SouthEastFPV/Typhon/README.md

# Typhon
Open Source FPV 5" & 6" Drone Racing Frame project initiated by SouthEastFPV - Rick Caudle AKA - SSBelmont
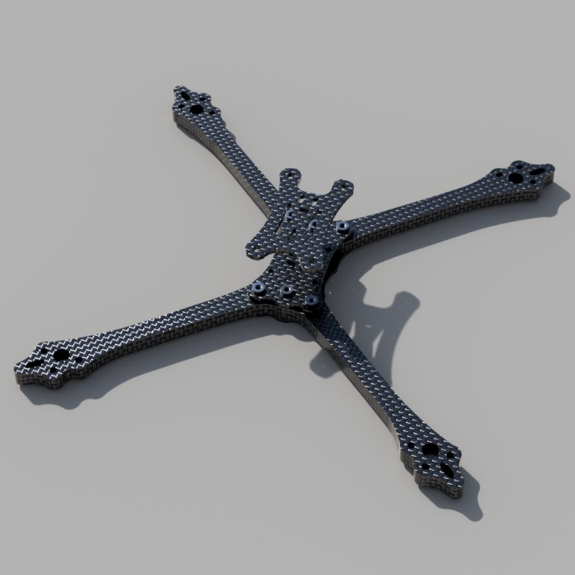
[picture p1: Images/T_v7_Assembly.jpg]


# About Typhon
## The idea
The Typhon was born out of the need for a 6" lite weight race frame that is durable and can compete with the fastest pilots in the world.  This is a design concept I came up and iterated on with Mason "Hyper" Lively as well as Randy "Gator" Jeppesen over the course of the 2021 season and this is the 7th version and it has turned out perfect. This frame allowed Mason to capture the Top Qualifying Time at the 2021 MultiGP Champs with Mason finishing in 5th (two mid-airs). Sp3cimen finished 3rd on this frame in the Sportsman Class and several others making it the top 40 and next 40.  The frame is 25-30g lighter than other 6" race frames and if I released 5" arms it would be lighter than that bestselling 5" race frames on the market and surely more durable.  This current designed if using T700 for the arms is in fact more durable than the top selling race from on the market as of 2021.

Top MultiGP Pilots currently flying this frame are Mason "Hyper" Lively, Tristan "TDog_FPV" Tefft, Rick "SSBelmont" Caudle, Randy "Gator" Jeppesen, Ryan "MegaHurts" Davis, ProDangles, SolidFPV, CoryRC, Sp3cimen and several other pilots.

Typhon
Typhon (/ˈtaɪfɒn, -fən/; Greek: Τυφῶν, [typʰɔ̂ːn]), also Typhoeus (/taɪˈfiːəs/; Τυφωεύς), Typhaon (Τυφάων) or Typhos (Τυφώς), was a monstrous serpentine giant and one of the deadliest creatures in Greek mythology. According to Hesiod, Typhon was the son of Gaia and Tartarus. However, one source has Typhon as the son of Hera alone, while another makes Typhon the offspring of Cronus. Typhon and his mate Echidna were the progenitors of many famous monsters.

# Changelog
## 4/16/2013
- Refactored the repo added various folders making it easier to navigate and understand what is what
- Created/Added **Long and Extra Long Bodies** to accomidate the new ESCs [click here](/Long%20Bodies/Readme.md) to navigate to the Long Bodies.
- Created/Added **Shorty Arms** (5" Short Arms) section [click here](/Shorty%20Arms/Readme.md) to navigate to the Shorty Arms.
- Created/Added **Arm Locks** section [click here](/Arm%20Locks/Readme.md)to navigate to the Arm Locks.
- Created folder for long arms (6" Arms) [click here](/Long%20Arms) to navigate to the Long Arms folder.

## Frame specifications
* Wheelbase 5" or 6": 226mm (when using the 6" arms)
* Top plate: 2mm
* Mid plate: 2mm
* Bottom plate 2mm
* Arm: 6mm or 5mm
* Brace: 4mm (braces are optional, I personally don't use them)
* Lipo Pad: 2mm (will release files soon)
* Stack mounting:  20 x 20
* Weight 6": 54g (lighter if using 5" shorty arms)

## Hardware
* 4x M3x20 or M3x25 Knurled Standoffs  (personal preference)
* 2x M3x10 Flat Head Socket Bolts 12.9 Black Steel
* 4x M3x18 Flat Head Socket Bolts 12.9 Black Steel
* 4x M3x8 Button Head Bolts
* 12x M3x8mm Socket Head Bolts (motor mounting)
* 6x M3 Press Nuts
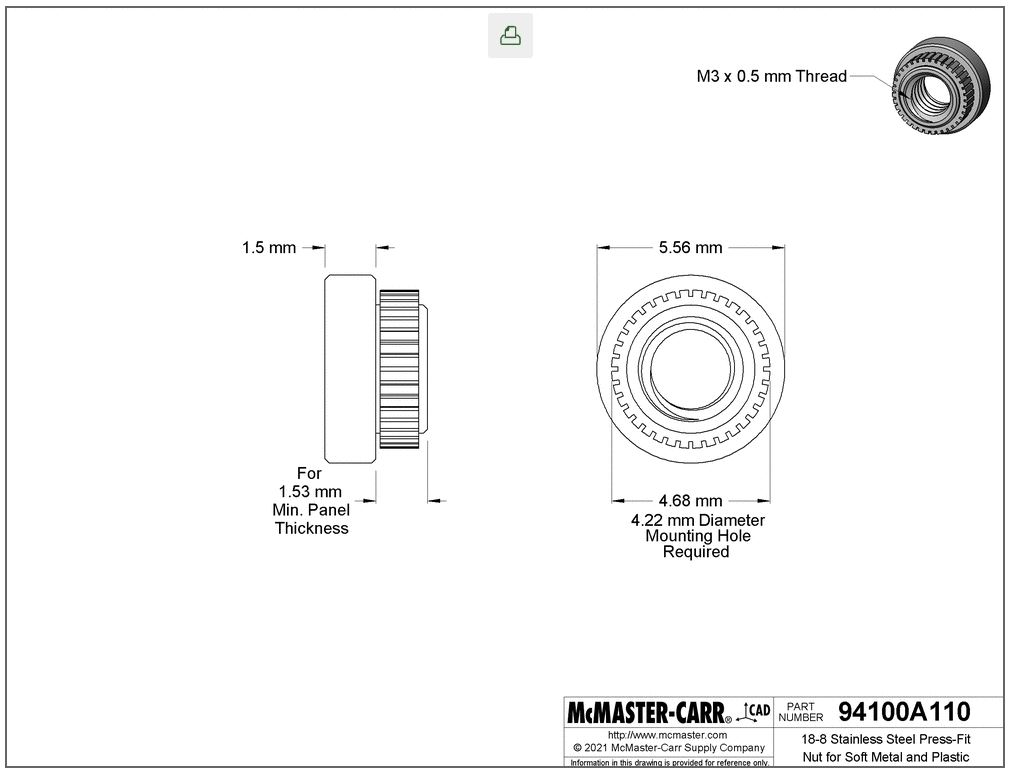
[picture p2: Images/PressNut.JPG]


## Additional Arms
I have designed a short skinny 5" arm in both 5mm and 6mm thickness.  I have also designed a 5.5" skinny arm that is based on the short skinny arm in both 5mm and 6mm thickness.  Again, it's important to use T700 CF and often times China will sell you T300 and tell you it's T700.  One way to tell is it's T300 is to break a known T300 arm and break T700 arm, the CF thread count is higher for the T700.  It's not perfect but if the 6mm arms are breaking and getting twisty after 10-20 packs it's likely not T700.  I have had 6mm T700 arms last me the whole season in 2021 all the way up to IO.

I have included .STEP, .F3D and .IGES files.  In some cases I provide .DXF but the .STEP, F3D and .IGES files are 3D drawings, so if you need a 2D file you can export form these.  All these files can be find in the folder.

## Shorty 5" Arms
[Click here](/Shorty%20Arms/Readme.md) to navigate to the Shorty Arm section.<br>
[5" 5mm Shorty Arms](/Shorty%20Arms/5mm)<br>
[5" 6mm Shorty Arm](/Shorty%20Arms/6mm)<br>
[5" Shorty Arm Braces](/Shorty/Arm%20Brace/)

Don't forget to have some arm locks cut!

## Arm Locks
You will need quanity 2 of these for each build.
[Click here](/Arm%20Locks/Readme.md) to navigate to the Arm Locks section

## Original Body
The frame was originally designed with these files being used for the mid-body section.<br>
[Click here](/Regular%20Body) to navigate to the Original Body section/files.

## Long & Extra Long Bodies
These mid-bodies are perfect for the longer 20x20 ESCs.<br>
[Click here](/Long%20Bodies) to navigate to the Original Body section/files.

## Original Arms
This frame was originally designed with a longer arm (6") as Hyper liked the longer arms with a 5.1" prop. <br>
[Click here](/Long%20Arms) to navigate to the Original Arms section/files.

## Conclusion
My general conclusion is our motors have so much torque today, you need a wider 5mm Arm or a thicker skinny arm and it needs to be cut from T700 CF.  So the 5" 5mm skinny arms I am not a huge fan of (I recommend an arm brace when using 5mm skinny arms).  You will get much better performance from a 6mm skinny arm with very little additional weight.  It's possible to cut these out of 5.5mm thickness but I think it's a waste of time, just use 6mm, the weight savings isn't worth it. 

## Project links
* Project discussion: https://discord.gg/AsXFzmGM
* Project files: https://github.com/SouthEastFPV/Typhon
* 3D-printed accessories: https://www.thingiverse.com/tag:typhon

Please use the tag "typhon" when uploading files to thingiverse.com

## Where to buy
* You can purchase a Typhon from https://dindrones.com/. Din is a trusted business owner and avid MultiGP Pro Pilot and is well known.

## Carbon Fiber sources and CNC Services
More Information on CNC/Carbon Fiber cutting services 
[click here](/CNC/CF_CNCServices.md)

### Typhoon v7
* v7 Design complete/tested/vetted during many MultiGP Events and flown by many of the Top MultiGP Pilots i.e. Mason "Hyper" Lively, Tristan "TDog_FPV" Tefft, Rick "SSBelmont" Caudle, Randy "Gator" Jeppesen, Ryan "MegaHurts" Davis, ProDangles, SolidFPV, CoryRC, Sp3cimen

* initial release from SouthEast FPV

## Project license
The frame files are released under GNU Public License (GPL) V3. More information here: https://www.gnu.org/licenses/gpl-3.0.en.html.  If you design any new parts for this frame, per the license you need to make those files availabe to the public.  

## Project naming requirements
Typhon is the name of the frame.  If you are thinking about manufacturing it, you are expected to prefix the name with a brand name in order to allow customers to distinguish the different manufacturers, e.g. “SOUTHEAST TYPHON”. As a manufacturer you are also expected to denote the version number of the frame files that you have used as basis of the project, e.g. “SOUTHEAST TYPHON V7”.

If you have forked the project, you need to give it another name in order to avoid confusion between TYPHON and your project.
Accessories from the TYPHON project also needs to be named with the entire prefix, e.g. “SOUTHEAST TYPHON FPV Camera Mount”. Unless the file is not compatible with certain versions of the frame, the compatible version number or version range also needs to be included in the name, e.g. “SOUTHEAST TYPHON FPV Camera Mount V1 - V2”.
