SouthEastFPV/Typhon/Shorty Arms/Readme.md

# Typhon Shorty Arms 
**Update: 4/16/2023** <br>
**Adds Made By: Rick (SSBelmont)**

These arms are as short as possible but will still allow for a 5.1" props.  The goal is to have a very light arm but yet still durable.  I run both the Shorty 5mm Arms and 6mm Arms (I lean toward the 6mm arms).

Take a look at the images below to get an idea of the difference in sizes.

## Shorty Arm
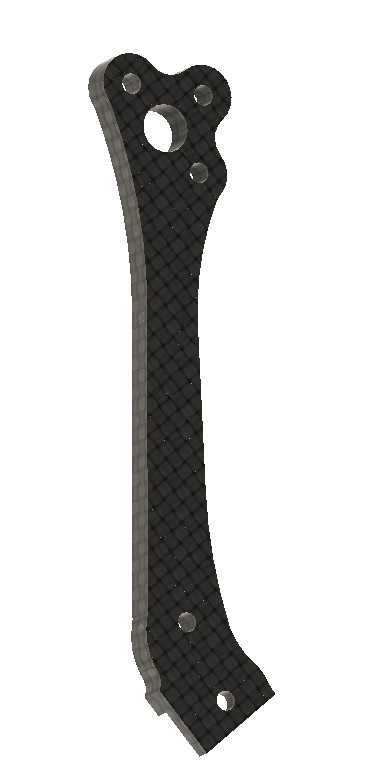
[picture p3: Images/Shorty_Arms/Shorty_Arm.jpg]


## Shorty Arm Brace
I don't run the brace with my 6mm Arms but I do run it on my Shorty 5mm Arm builds.  You don't have to use the brace with the 5mm arms, but you will find it allows the arms to last much longer.  As with any skinny 5mm Arm, they will delaminate over time and will get twisty resulting in the quad not flying as well (will cause hot motors as well).
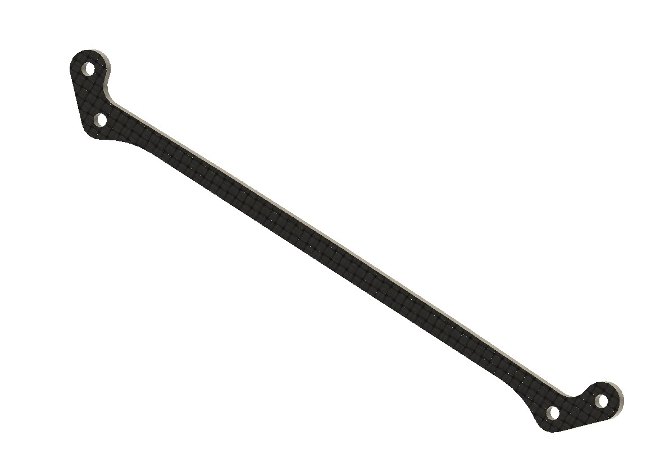
[picture p4: Images/Shorty_Arms/Shorty_Arm_Brace_3mm.jpg]


Shorty Arm File(s):
| Description | File(s) |
| ---- | ---- |
| 5mm Shorty Arm | T_v8_Bottom_Plate_L.dxf or T_v8_Bottom_Plate_L.step |
| 6mm Shorty Arm | T_v7_Shorty_Arm_5_Inch_6mm.dxf, T_v7_Shorty_Arm_5_Inch_6mm.step |

[Click here](/Shorty%20Arms/5mm) to navigate to the 5mm Shorty Arms folder to download files.<br>
[Click here](/Shorty%20Arms/6mm) to navigate to the 6mm Shorty Arms folder to download files.

## Don't forget your Arm Locks!
[Click here](/Arm%20Locks/Readme.md) to navigate to the Arm Locks Section.

## Files are located in their respective folders
Navigate to the folder and download the files you need, or learn how to use GitHub and clone the repo locally to get all the files, or download the repo as a zip file.
