SouthEastFPV/Typhon/Long Bodies/Readme.md

# Typhon Long Bodies
**Update: 4/16/2023** <br>
**Adds Made By: Rick (SSBelmont)**

Many people have asked me to design a long body in order to allow for the longer ESCs that are being sold today.  As result I have created two long bodies, a Long and an Extra Long version.  The Long version will work fine with with the TMotor 60a, Foxeer Reaper Slim, Rush, Redux 60a, Redux 70a.  The XL will work with any of the 20x20 ESCs on the market and gives more clearance near the center pressnut in the mid-plate.

Take a look at the images below to get an idea of the difference in sizes.

## Long & Extra Long Bodies
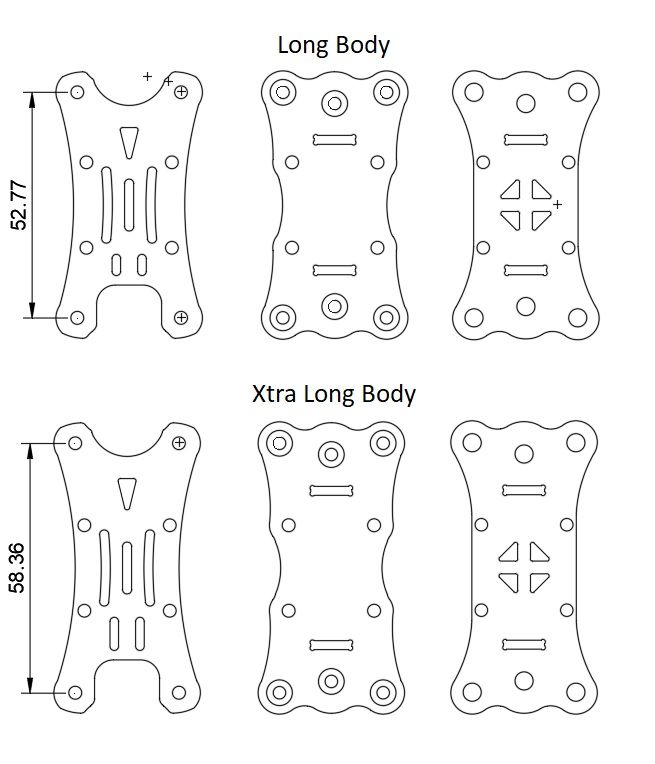
[picture p5: Images/Long_Body/Long Bodies.jpg]

Long Body File(s):
| Description | File(s) |
| ---- | ---- |
| Long Bottom Plate | T_v8_Bottom_Plate_L.dxf or T_v8_Bottom_Plate_L.step |
| Long Mid Plate | T_v8_Mid_Plate_L.dxf or T_v8_Mid_Plate_L.step |
| Long Top Plate |  T_v8_Top_Plate_L.dxf or T_v8_Top_Plate_L.step |

Extra Long Body File(s):
| Description | File(s) |
| ---- | ---- |
| XL Bottom Plate | T_v9_Bottom_Plate_XL_2mm.dxf or T_v9_Mid_Plate_XL_2mm.step|
| XL Mid Plate | T_v9_Mid_Plate_XL_2mm.dxf or T_v9_Mid_Plate_XL_2mm.step |
| XL Top Plate | T_v9_Top_Plate_XL.dxf or T_v9_Top_Plate_XL.step |

Now, compare the long bodies to the regular body to get a better understanding of the differences

## Regular Body
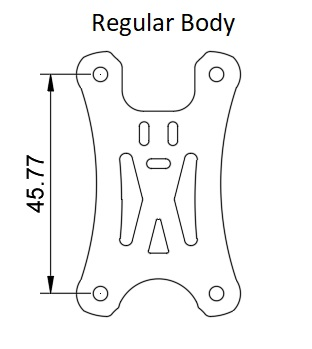
[picture p6: Images/Long_Body/Regular Body.jpg]


## Files are located in their respective folders
Navigate to the folder and download the files you need, or learn how to use GitHub and clone the repo locally to get all the files, or download the repo as a zip file.

## Don't forget your Arm Locks!
[Click here](/Long%20Bodies/Long) to navigate to the Long Body Folder to download files.
