SouthEastFPV/Typhon/Regular Body/Readme.md

# Regular Body
This section contains all the mid-body parts for the original design.
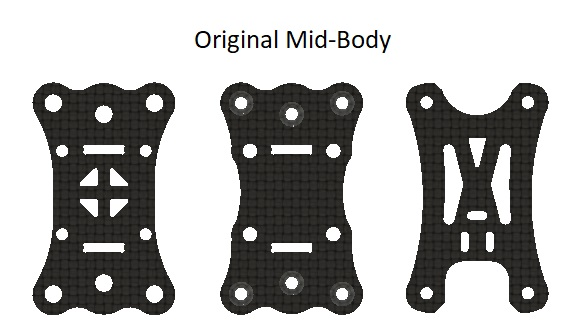
[picture p9: Images/Regular_Body/Regular Body.jpg]


This mid-body will be challenging to use with the longer style ESCs, you may want to checkout the Long Bodies if you plan to run longer 20x20 ESCs.<br>  
[Click here](/Long%20Bodies) to navigate to the Long Bodies.
