SouthEastFPV/Typhon/Frame_Assembly/T_v7_Assembly v3.step

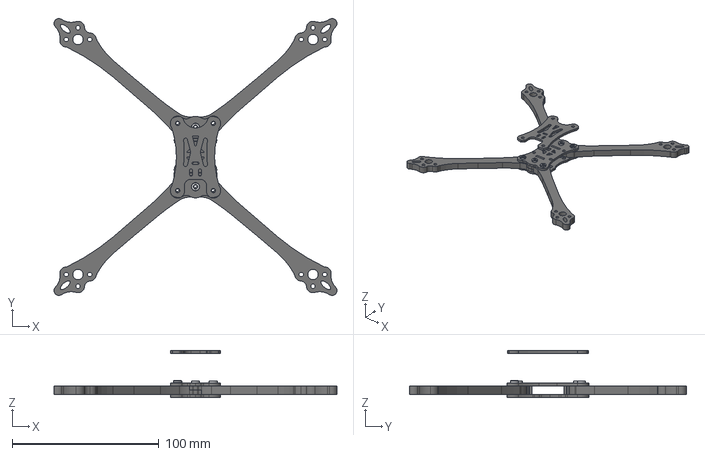
[picture p10: CAD file, 2023-04-16]
Frame_Assembly/T_v7_Assembly v3.step
192.7 x 188.5 x 32.0 mm
Pressnut v2 x 6
