SouthEastFPV/Typhon/Frame_Assembly/T_v7_Assembly.dxf

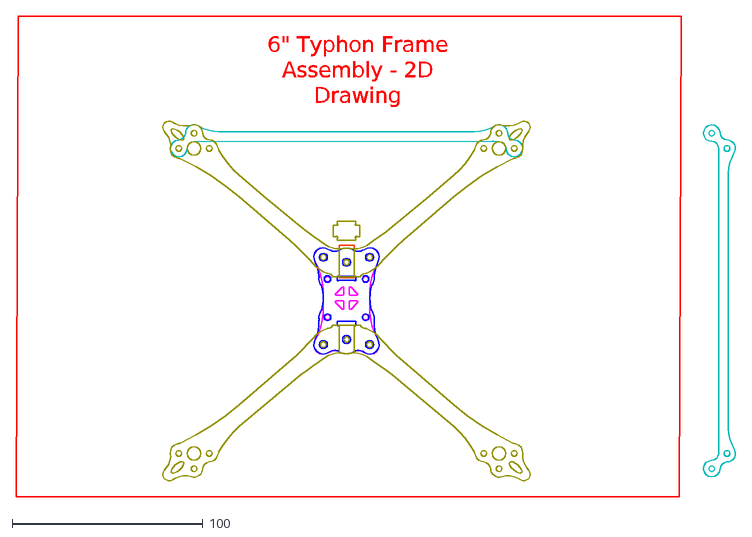
[picture p11: CAD file, 2021-11-11]
Frame_Assembly/T_v7_Assembly.dxf
6" Typhon Frame Assembly - 2D Drawing
