SouthEastFPV/Typhon/5 inch Arms/T_v7_Arm_5_Inch_Shorty_6mm.step

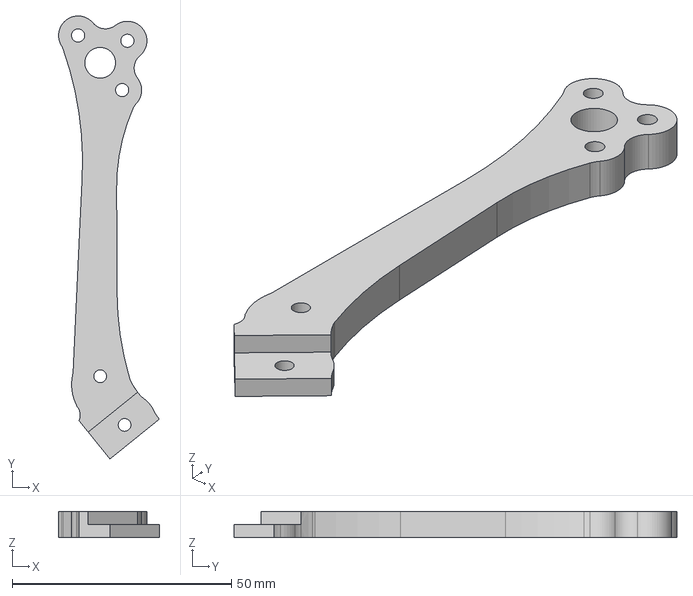
[picture p12: CAD file, 2022-09-27]
5 inch Arms/T_v7_Arm_5_Inch_Shorty_6mm.step
23.0 x 101.0 x 6.00 mm
