SouthEastFPV/Typhon/Arm Locks/5mm/T_v8_Arm_Lock_5_Inch_2mm..step

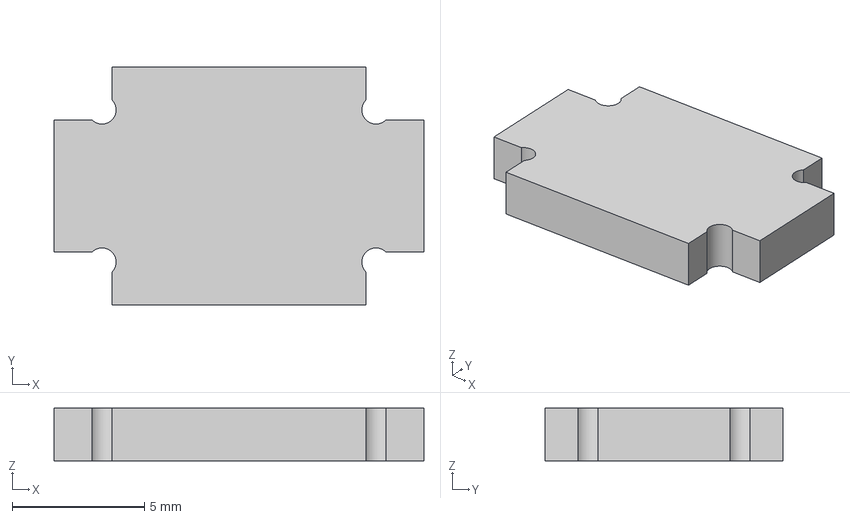
[picture p13: CAD file, 2023-04-16]
Arm Locks/5mm/T_v8_Arm_Lock_5_Inch_2mm..step
14.0 x 9.00 x 2.00 mm
