SouthEastFPV/Typhon/Arm Locks/6mm/T_v8_Arm_Lock_6_Inch_2mm.step

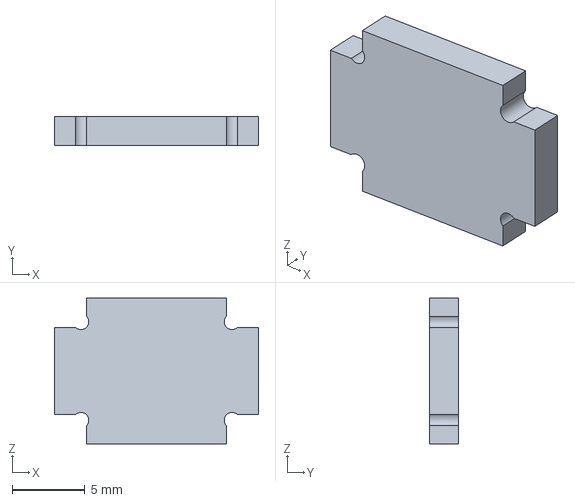
[picture p14: CAD file, 2023-04-16]
Arm Locks/6mm/T_v8_Arm_Lock_6_Inch_2mm.step
14.0 x 2.00 x 10.0 mm
