SouthEastFPV/Typhon/Long Arms/T_v7_Arm_5mm v2.step

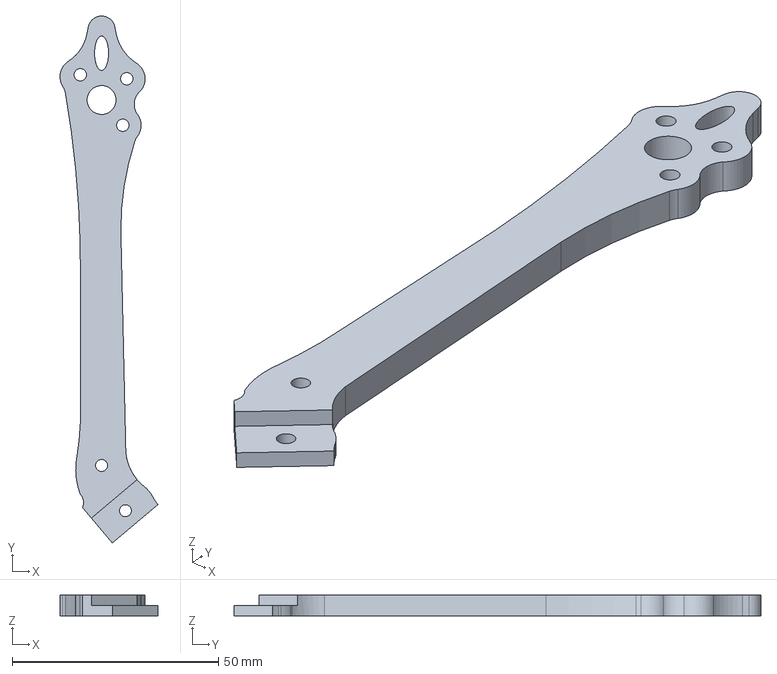
[picture p15: CAD file, 2021-11-11]
Long Arms/T_v7_Arm_5mm v2.step
23.8 x 127.8 x 5.00 mm
