SouthEastFPV/Typhon/Long Bodies/Long/Bottom Plate/T_v8_Bottom_Plate_L.step

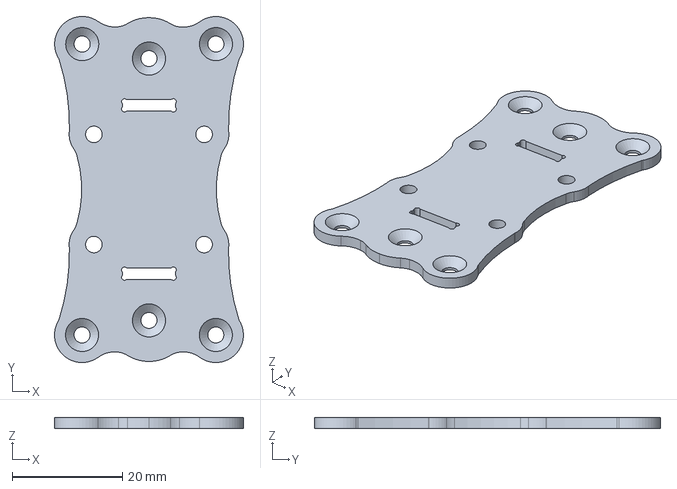
[picture p16: CAD file, 2023-04-16]
Long Bodies/Long/Bottom Plate/T_v8_Bottom_Plate_L.step
34.3 x 62.8 x 2.00 mm
