SouthEastFPV/Typhon/Long Bodies/Long/Mid Plate/T_v8_Mid_Plate_L.step

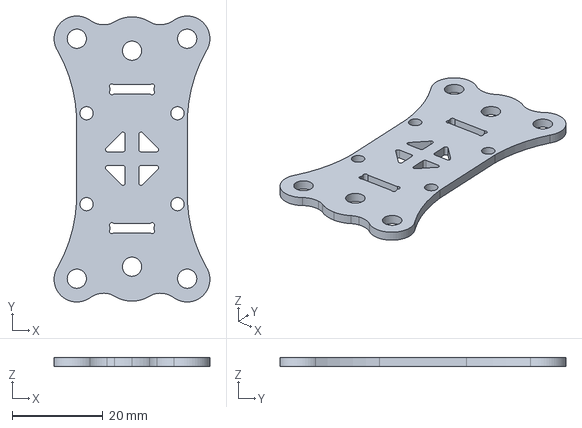
[picture p17: CAD file, 2023-04-16]
Long Bodies/Long/Mid Plate/T_v8_Mid_Plate_L.step
34.3 x 62.9 x 2.00 mm
