SouthEastFPV/Typhon/Long Bodies/Long/Top Plate/T_v8_Top_Plate_L.step

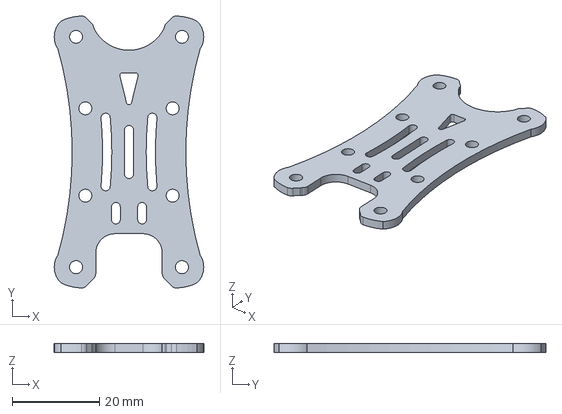
[picture p18: CAD file, 2023-04-16]
Long Bodies/Long/Top Plate/T_v8_Top_Plate_L.step
34.3 x 62.3 x 2.00 mm
