SouthEastFPV/Typhon/Long Bodies/X_Long/Bottom Plate/T_v9_Mid_Plate_XL_2mm.step

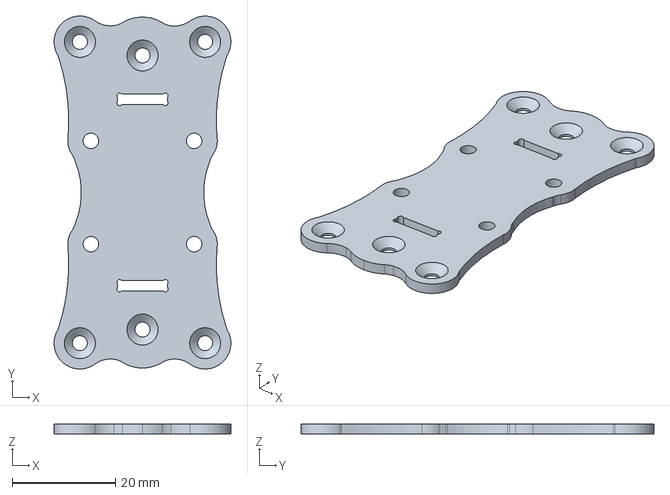
[picture p19: CAD file, 2023-04-16]
Long Bodies/X_Long/Bottom Plate/T_v9_Mid_Plate_XL_2mm.step
34.3 x 68.4 x 2.00 mm
