SouthEastFPV/Typhon/Long Bodies/X_Long/Top Plate/T_v9_Top_Plate_XL.step

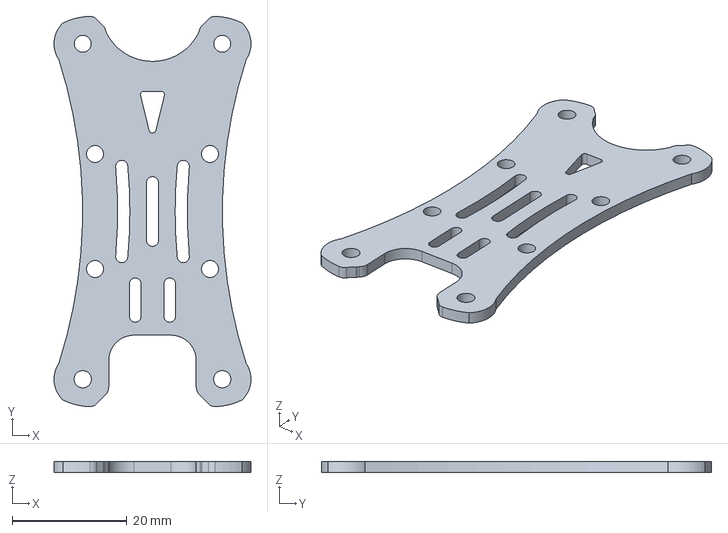
[picture p21: CAD file, 2023-04-16]
Long Bodies/X_Long/Top Plate/T_v9_Top_Plate_XL.step
34.3 x 67.9 x 2.00 mm
