SouthEastFPV/Typhon/Shorty Arms/5mm/T_v7_Shorty_Arm_5_Inch_5mm.step

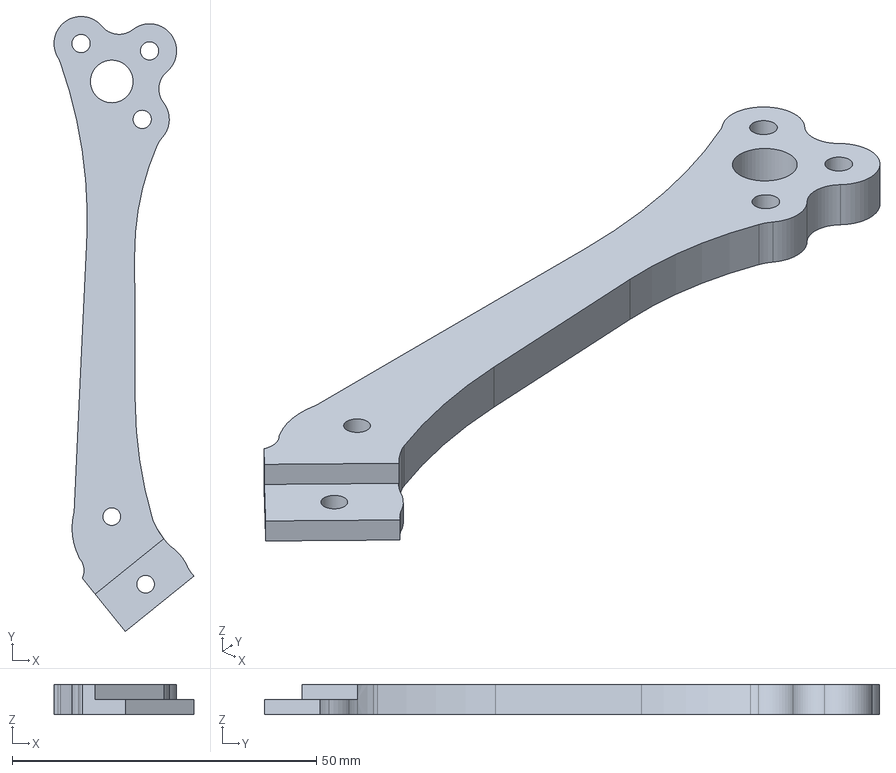
[picture p22: CAD file, 2023-04-16]
Shorty Arms/5mm/T_v7_Shorty_Arm_5_Inch_5mm.step
23.0 x 101.0 x 5.00 mm
