SouthEastFPV/Typhon/Shorty Arms/Arm Brace/T_v7_5_Inch_Shorty_Brace_3mm.step

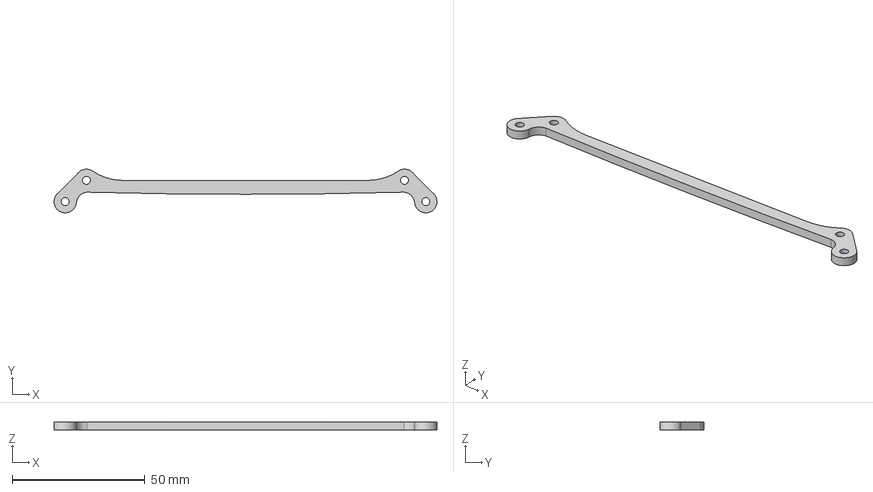
[picture p23: CAD file, 2022-09-27]
Shorty Arms/Arm Brace/T_v7_5_Inch_Shorty_Brace_3mm.step
144.0 x 16.4 x 3.00 mm
