SouthEastFPV/Typhon/Long Arms/T_Arm_6mm v2.step

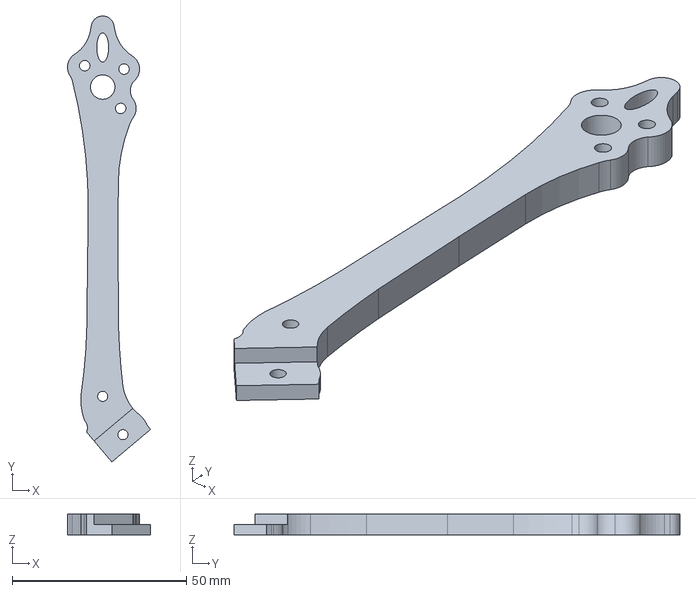
[picture p24: CAD file, 2021-11-11]
Long Arms/T_Arm_6mm v2.step
23.8 x 127.9 x 6.00 mm
