SouthEastFPV/Typhon/Long Bodies/X_Long/Bottom Plate/T_v9_Bottom_Plate_XL_2mm.dxf

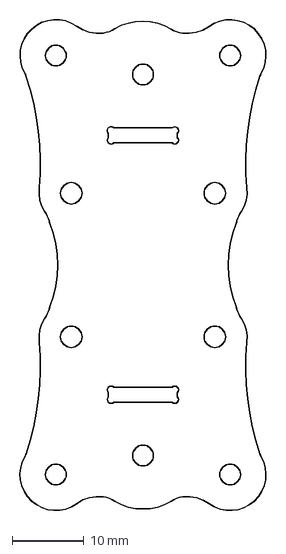
[picture p25: CAD file, 2023-04-16]
Long Bodies/X_Long/Bottom Plate/T_v9_Bottom_Plate_XL_2mm.dxf
35.3 x 69.3 mm
