SouthEastFPV/Typhon/Long Arms/T_v7_Brace_4mm_2x.dxf

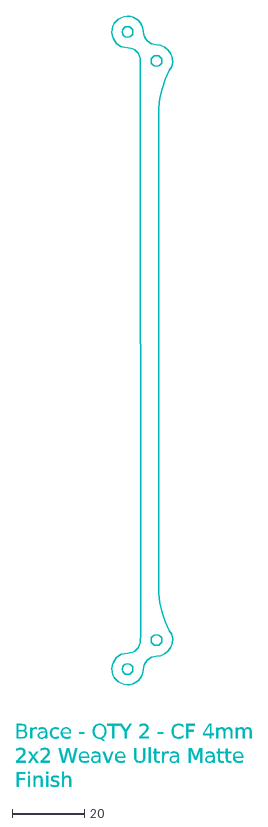
[picture p26: CAD file, 2021-11-11]
Long Arms/T_v7_Brace_4mm_2x.dxf
Brace - QTY 2 - CF 4mm 2x2 Weave Ultra Matte Finish
