SouthEastFPV/Typhon/5 inch Arms/T_v7_Arm_5.5_Inch_6mm.step

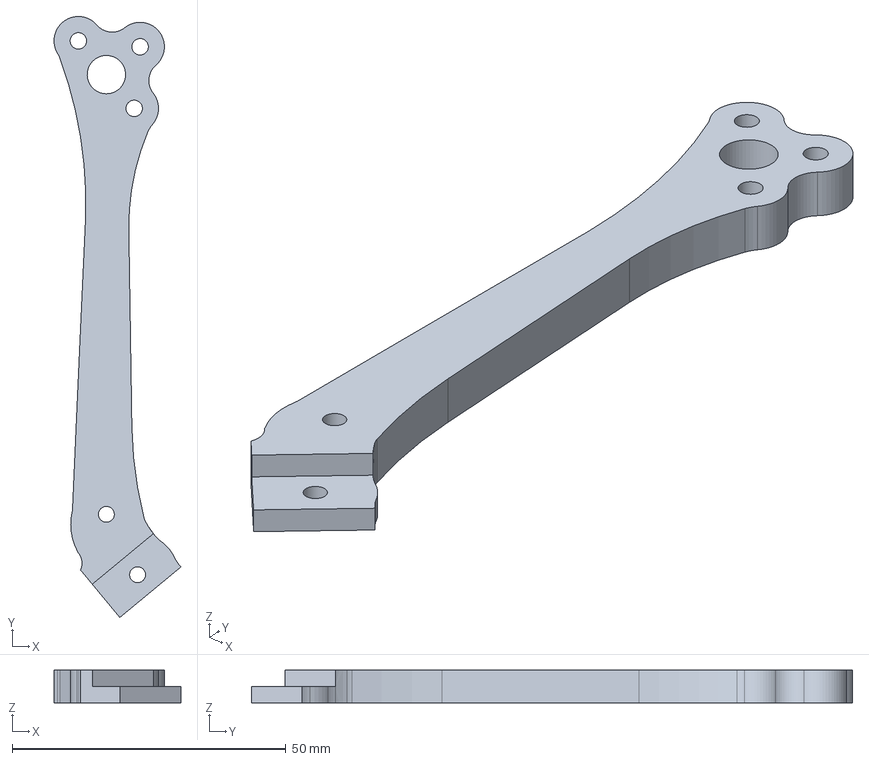
[picture p27: CAD file, 2022-09-27]
5 inch Arms/T_v7_Arm_5.5_Inch_6mm.step
23.2 x 109.7 x 6.00 mm
