SouthEastFPV/Typhon/(list of files, cad)

Other CAD files:
Regular Body/T_v7_Top_Plate.dxf
Shorty Arms/6mm/T_v7_Shorty_Arm_5_Inch_6mm.step
5 inch Arms/T_v7_Arm_5_Inch_Shorty_5mm.step
Regular Body/T_v7_Mid_Plate.dxf
5 inch Arms/T_v7_5_Inch_Arm_Lock_2mm.step
Regular Body/T_v7_Bottom_Plate.dxf
Long Arms/T_v7_Arm_6mm_4x.dxf
Long Arms/T_v7_Arm_5mm_4x.dxf
5 inch Arms/T_v7_Arm_5.5_Inch_6mm.dxf
5 inch Arms/T_v7_Arm_5.5_Inch_6mm.f3d
5 inch Arms/T_v7_Arm_5.5_Inch_6mm.iges
5 inch Arms/T_v7_Arm_5_Inch_Shorty_5mm.dxf
5 inch Arms/T_v7_Arm_5_Inch_Shorty_6mm.f3d
5 inch Arms/T_v7_Arm_5_Inch_Shorty_6mm.iges
Arm Locks/5mm/T_v8_Arm_Lock_5_Inch_2mm.dxf
Arm Locks/6mm/T_v8_Arm_Lock_6_Inch_2mm.dxf
Frame_Assembly/T_v7_Assembly v3.f3d
Frame_Assembly/T_v7_Assembly v3.iges
Long Arms/T_Arm_6mm v2.f3d
Long Arms/T_Arm_6mm v2.iges
Long Arms/T_v7_Arm_5mm v2.f3d
Long Arms/T_v7_Arm_5mm v2.iges
Long Bodies/Long/Bottom Plate/T_v8_Bottom_Plate_L.dxf
Long Bodies/Long/Mid Plate/T_v8_Mid_Plate_L.dxf
Long Bodies/Long/Top Plate/T_v8_Top_Plate_L.dxf
Long Bodies/X_Long/Mid Plate/T_v9_Mid_Plate_XL_2mm.dxf
Long Bodies/X_Long/Top Plate/T_v9_Top_Plate_XL.dxf
Shorty Arms/5mm/T_v7_Shorty_Arm_5_Inch_5mm.dxf
Shorty Arms/6mm/T_v7_Shorty_Arm_5_Inch_6mm.f3d
Shorty Arms/Arm Brace/T_v7_5_Inch_Shorty_Brace_3mm.dxf
