SouthEastFPV/Typhon/(commit log)

2021-11-11 Major updates
    Major updates
    [T_v4_Arm_Lock2.dxf, T_v7_Arm_5mm_4x.dxf, T_v7_Arm_6mm_4x.dxf, T_v7_Arm_Lock1_2x.dxf, T_v7_Arm_Lock2_2x.dxf, T_v7_Assembly.dxf, T_v7_Bottom_Plate.dxf, T_v7_Brace_4mm_2x.dxf]
2021-11-11 3D Files
    3d files uploaded
    [T_v7_Assembly v3.f3d, T_v7_Assembly v3.iges, T_v7_Assembly v3.step]
2021-11-11 3D Files
    3D Files
    [T_Arm_6mm v2.f3d, T_Arm_6mm v2.iges, T_Arm_6mm v2.step, T_v7_Arm_5mm v2.f3d, T_v7_Arm_5mm v2.iges, T_v7_Arm_5mm v2.step]
2022-09-27 Add additional files and update the notes
    [T_v7_5_Inch_Arm_Lock_2mm.step, T_v7_5_Inch_Shorty_Brace_3mm.step, T_v7_Arm_5.5_Inch_6mm.dxf, T_v7_Arm_5.5_Inch_6mm.f3d, T_v7_Arm_5.5_Inch_6mm.iges, T_v7_Arm_5.5_Inch_6mm.step, T_v7_Arm_5_Inch_Shorty_5mm.dxf, T_v7_Arm_5_Inch_Shorty_5mm.step]
2023-04-16 Rename T_Arm_6mm v2.iges to Long Arms/T_Arm_6mm v2.iges
    [T_Arm_6mm v2.iges]
2023-04-16 Rename T_Arm_6mm v2.step to Long Arms/T_Arm_6mm v2.step
    [T_Arm_6mm v2.step]
2023-04-16 Rename T_v7_Arm_5mm v2.iges to Long Arms/T_v7_Arm_5mm v2.iges
    [T_v7_Arm_5mm v2.iges]
2023-04-16 Rename T_v7_Arm_5mm v2.step to Long Arms/T_v7_Arm_5mm v2.step
    [T_v7_Arm_5mm v2.step]
2023-04-16 Rename T_v7_Arm_5mm_4x.dxf to Long Arms/T_v7_Arm_5mm_4x.dxf
    [T_v7_Arm_5mm_4x.dxf]
2023-04-16 Rename T_v7_Arm_6mm_4x.dxf to Long Arms/T_v7_Arm_6mm_4x.dxf
    [T_v7_Arm_6mm_4x.dxf]
2023-04-16 Rename T_v7_Assembly v3.step to Frame_Assembley/T_v7_Assembly v3.step
    [T_v7_Assembly v3.step]
2023-04-16 Rename Frame_Assembley/T_v7_Assembly v3.step to Frame_Assembly/T_v7_Assembly v3.step
    [T_v7_Assembly v3.step]
2023-04-16 Rename T_v7_Bottom_Plate.dxf to Regular Body/T_v7_Bottom_Plate.dxf
    [T_v7_Bottom_Plate.dxf]
2023-04-16 Rename T_v7_Mid_Plate.dxf to Regular Body/T_v7_Mid_Plate.dxf
    [T_v7_Mid_Plate.dxf]
2023-04-16 Rename T_v7_Top_Plate.dxf to Regular Body/T_v7_Top_Plate.dxf
    [T_v7_Top_Plate.dxf]
2023-04-16 Rename T_v7_Brace_4mm_2x.dxf to Long Arms/T_v7_Brace_4mm_2x.dxf
    [T_v7_Brace_4mm_2x.dxf]
